leszqq/usb-magnetometer.hardware/usb-magnetometer.step

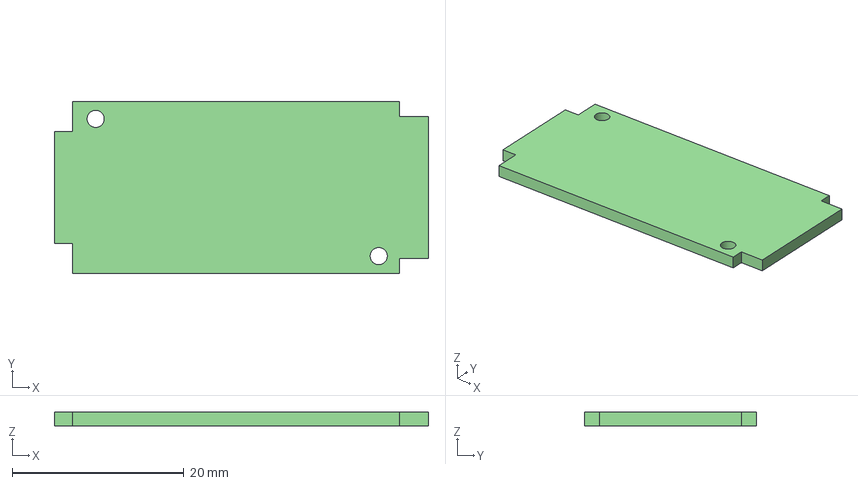
[picture p1: CAD file, 2023-02-05]
usb-magnetometer.step
43.6 x 20.0 x 1.60 mm
