leszqq/usb-magnetometer.hardware/sch.pdf

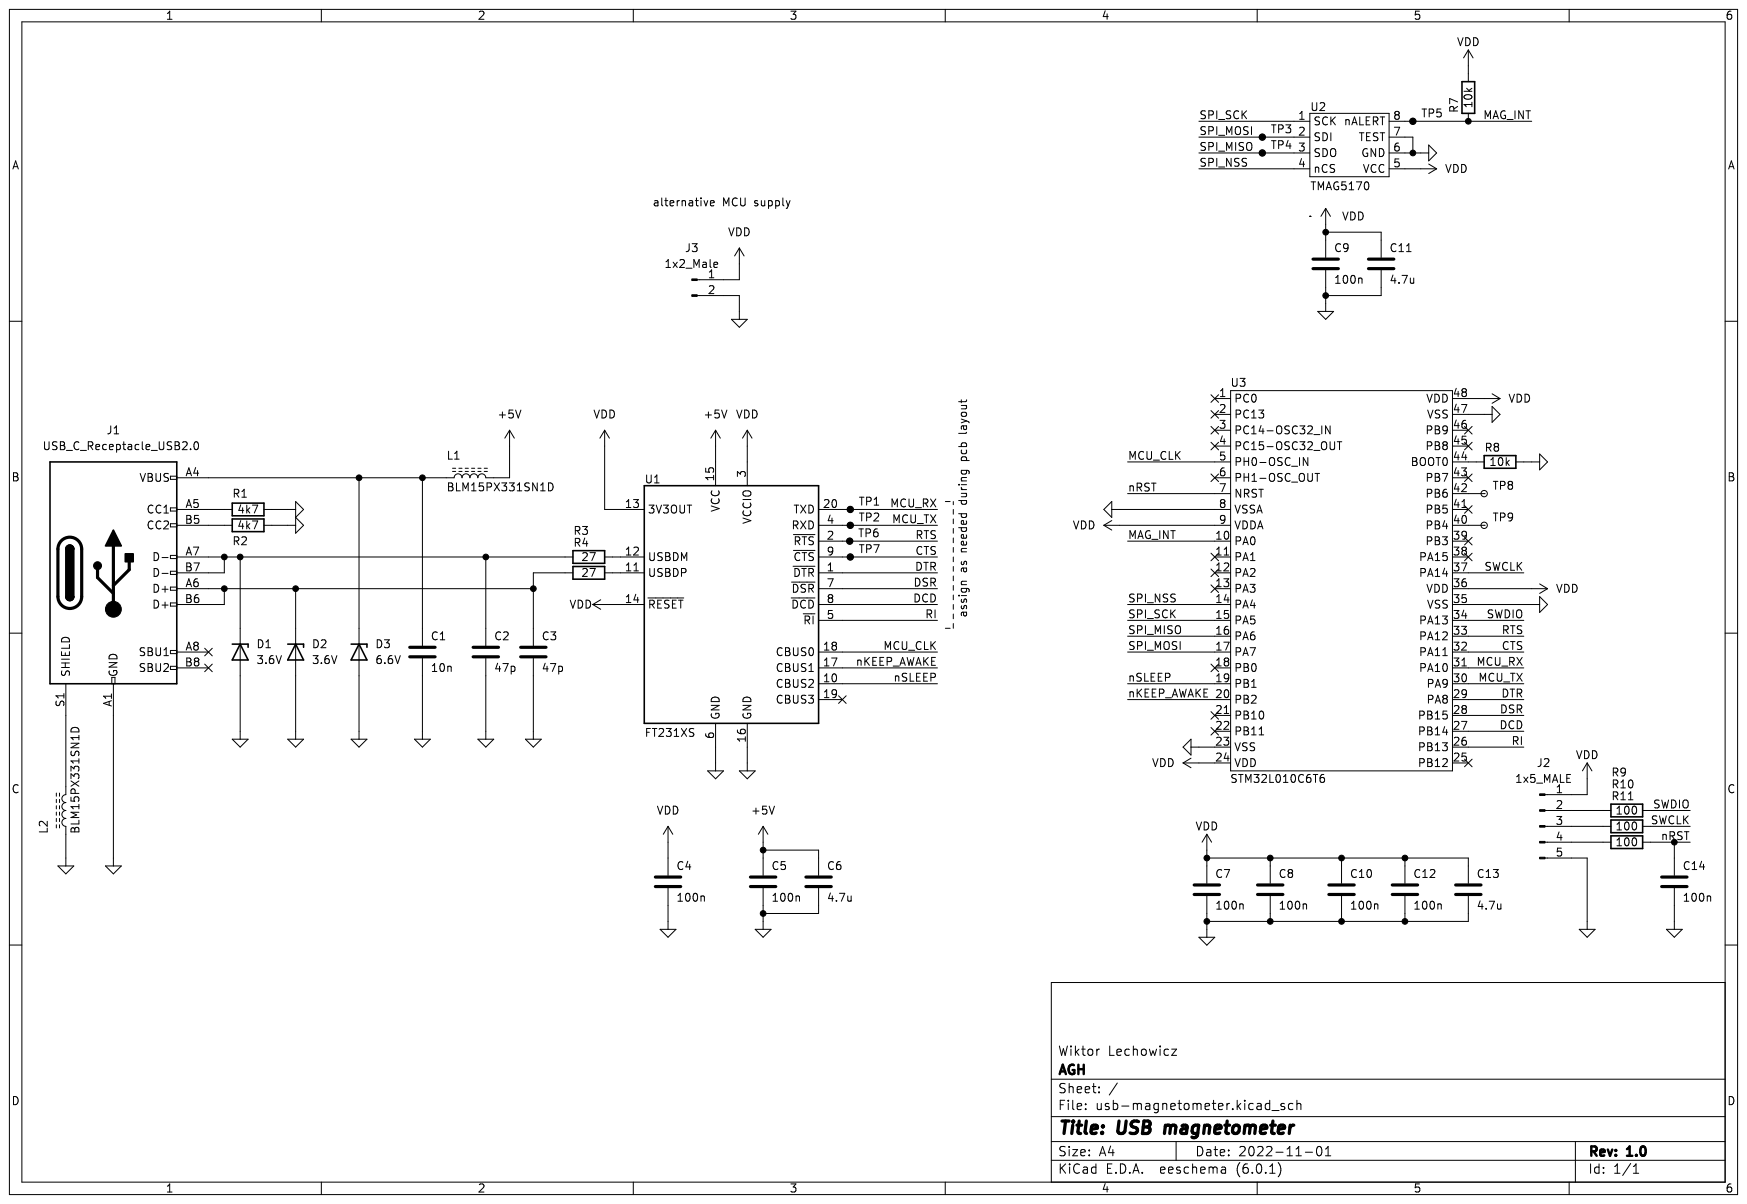
[picture p2: page 1]
