leszqq/usb-magnetometer.hardware/usb-magnetometer.kicad_pcb

## KiCad design usb-magnetometer.kicad_pcb (2023-03-18)

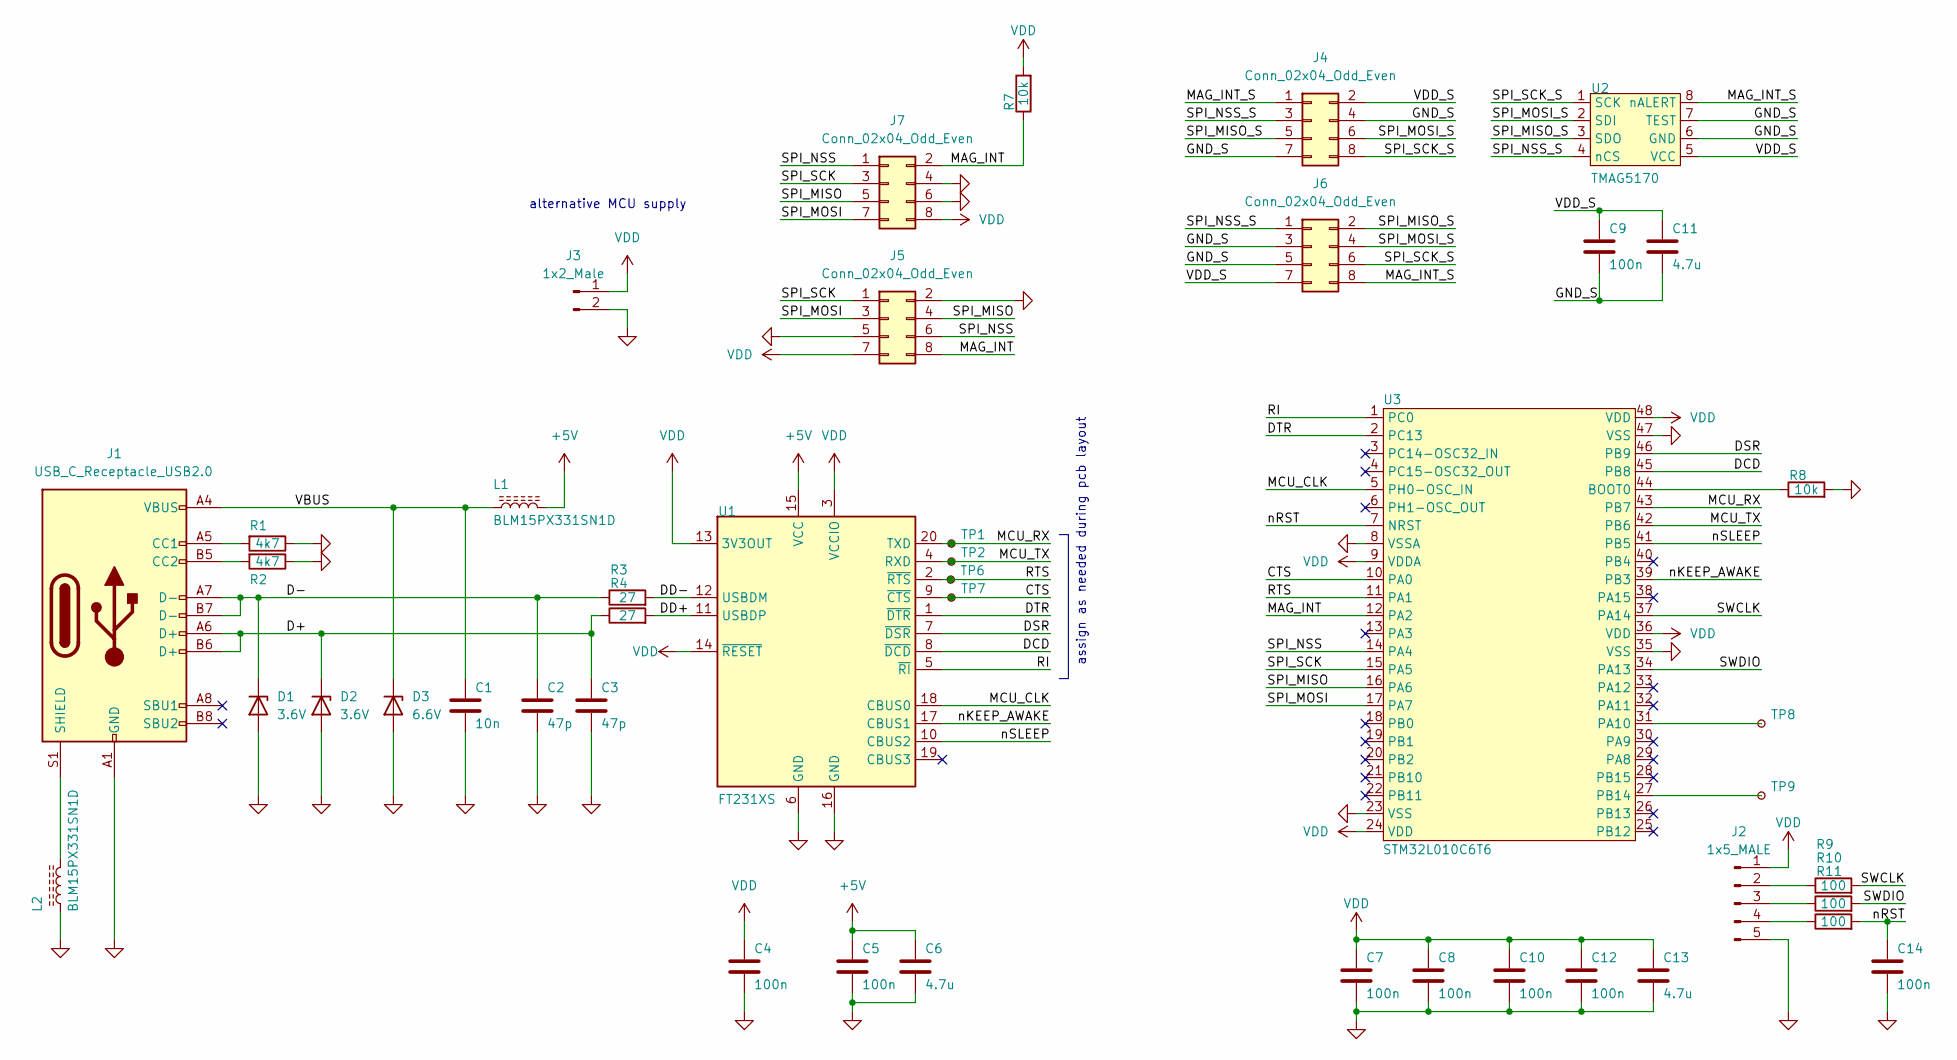
[picture p3: schematic usb-magnetometer.kicad_sch, USB magnetometer]

Parts:
C1: 10n; C_0402_1005Metric_Pad0.74x0.62mm_HandSolder; MPN VJ0402Y103JXQCW1BC
C2, C3: 47p; C_0402_1005Metric_Pad0.74x0.62mm_HandSolder; MPN CC0402JRNPO8BN470
C4, C5, C7, C8, C9, C10, C12, C14: 100n; C_0402_1005Metric_Pad0.74x0.62mm_HandSolder; MPN CL05A104KP5NNNC
C6, C11, C13: 4.7u; C_0402_1005Metric_Pad0.74x0.62mm_HandSolder; MPN CL05A475MP5NRNC
D1, D2: 3.6V; X1SON; MPN ESD321DPYR
D3: 6.6V; D_SOD-323_HandSoldering; MPN ESD3Z5V0
J1: USB_C_Receptacle_USB2.0; USB_C_Receptacle_JAE_DX07S016JA1R1500; MPN DX07S016JA1R1500
J2: 1x5_MALE; PinHeader_1x05_P2.54mm_Vertical; MPN *
J3: 1x2_Male; PinHeader_1x02_P2.54mm_Vertical; MPN *
J4, J5: Conn_02x04_Odd_Even; Hirose_FH12-8S-0.5SH_1x08-1MP_P0.50mm_Horizontal
J6, J7: Conn_02x04_Odd_Even; PinHeader_2x04_P1.00mm_Vertical
L1, L2: L_Ferrite; R_0402_1005Metric_Pad0.72x0.64mm_HandSolder; MPN BLM15PX331SN1D
R1, R2: 4k7; R_0402_1005Metric_Pad0.72x0.64mm_HandSolder; MPN RC0402JR-134K7L
R3, R4: 27; R_0402_1005Metric_Pad0.72x0.64mm_HandSolder; MPN RC0402JR-0727RL
R7, R8: 10k; R_0402_1005Metric_Pad0.72x0.64mm_HandSolder; MPN RC0402FR-0710KL
R9, R10, R11: 100; R_0402_1005Metric_Pad0.72x0.64mm_HandSolder; MPN RC0402FR-07100R
TP1, TP2, TP6, TP7, TP8, TP9: TestPoint_Small; TestPoint_Pad_D1.0mm
U1: FT231XS; SSOP-20_3.9x8.7mm_P0.635mm; MPN FT231XS-R
U2: TMAG5170; VSSOP-8_3.0x3.0mm_P0.65mm; MPN TMAG5170A1EDGKRQ1
U3: STM32L010C6T6; LQFP-48_7x7mm_P0.5mm; MPN STM32L010C6T6

Connections:
+5V: C5.1, C6.1, L1.2, U1.15 (VCC)
/CTS: TP7.1, U1.9 (~CTS), U3.10 (PA0)
/D+: C3.1, D2.1 (K), J1.A6 (D+), J1.B6 (D+), R4.1
/D-: C2.1, D1.1 (K), J1.A7 (D-), J1.B7 (D-), R3.1
/DCD: U1.8 (~DCD), U3.45 (PB8)
/DD+: R4.2, U1.11 (USBDP)
/DD-: R3.2, U1.12 (USBDM)
/DSR: U1.7 (~DSR), U3.46 (PB9)
/DTR: U1.1 (~DTR), U3.2 (PC13)
/GND_S: C9.2, C11.2, J4.4, J4.7, J6.3, J6.5, U2.6 (GND), U2.7 (TEST)
/MAG_INT: J5.8, J7.2, R7.1, U3.12 (PA2)
/MAG_INT_S: J4.1, J6.8, U2.8 (nALERT)
/MCU_CLK: U1.18 (CBUS0), U3.5 (PH0-OSC_IN)
/MCU_RX: TP1.1, U1.20 (TXD), U3.43 (PB7)
/MCU_TX: TP2.1, U1.4 (RXD), U3.42 (PB6)
/RI: U1.5 (~RI), U3.1 (PC0)
/RTS: TP6.1, U1.2 (~RTS), U3.11 (PA1)
/SPI_MISO: J5.4, J7.5, U3.16 (PA6)
/SPI_MISO_S: J4.5, J6.2, U2.3 (SDO)
/SPI_MOSI: J5.3, J7.7, U3.17 (PA7)
/SPI_MOSI_S: J4.6, J6.4, U2.2 (SDI)
/SPI_NSS: J5.6, J7.1, U3.14 (PA4)
/SPI_NSS_S: J4.3, J6.1, U2.4 (nCS)
/SPI_SCK: J5.1, J7.3, U3.15 (PA5)
/SPI_SCK_S: J4.8, J6.6, U2.1 (SCK)
/SWCLK: R9.2, U3.37 (PA14)
/SWDIO: R10.2, U3.34 (PA13)
/VBUS: C1.1, D3.1 (K), J1.A4 (VBUS), J1.A9 (VBUS), J1.B4 (VBUS), J1.B9 (VBUS), L1.1
/VDD_S: C9.1, C11.1, J4.2, J6.7, U2.5 (VCC)
/nKEEP_AWAKE: U1.17 (CBUS1), U3.39 (PB3)
/nRST: C14.1, R11.2, U3.7 (NRST)
/nSLEEP: U1.10 (CBUS2), U3.41 (PB5)
GND: C1.2, C2.2, C3.2, C4.2, C5.2, C6.2, C7.2, C8.2, C10.2, C12.2, C13.2, C14.2, D1.2 (A), D2.2 (A), D3.2 (A), J1.A1 (GND), J1.A12 (GND), J1.B1 (GND), J1.B12 (GND), J2.5, J3.2, J5.2, J5.5, J7.4, J7.6, L2.1, R1.1, R2.1, R8.2, U1.6 (GND), U1.16 (GND), U3.8 (VSSA), U3.23 (VSS), U3.35 (VSS), U3.47 (VSS)
unnamed: J1.A5 (CC1), R1.2
unnamed: J1.B5 (CC2), R2.2
unnamed: J1.S1 (SHIELD), L2.2
unnamed: J2.2, R9.1
unnamed: J2.3, R10.1
unnamed: J2.4, R11.1
unnamed: R8.1, U3.44 (BOOT0)
unnamed: TP8.1, U3.31 (PA10)
unnamed: TP9.1, U3.27 (PB14)
VDD: C4.1, C7.1, C8.1, C10.1, C12.1, C13.1, J2.1, J3.1, J5.7, J7.8, R7.2, U1.3 (VCCIO), U1.13 (3V3OUT), U1.14 (~RESET), U3.9 (VDDA), U3.24 (VDD), U3.36 (VDD), U3.48 (VDD)

Notes on the sheet:
assign as needed during pcb layout
alternative MCU supply

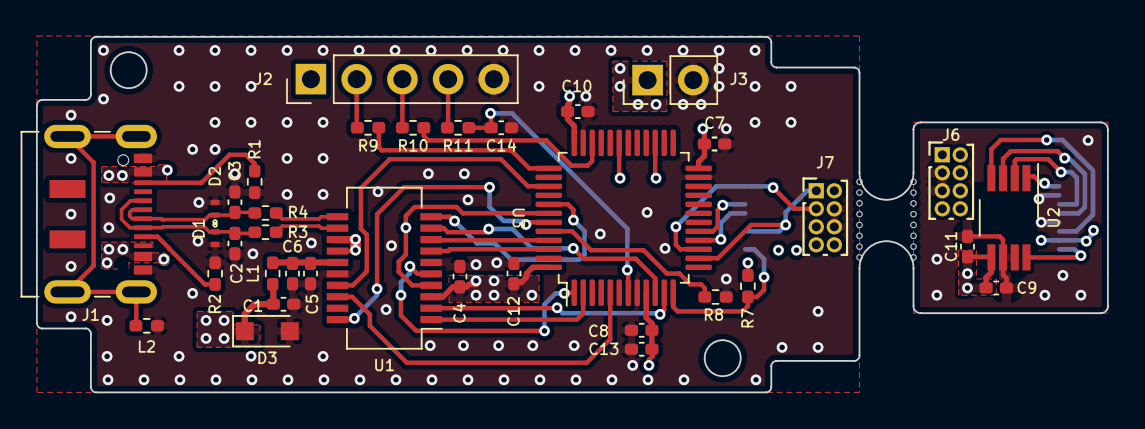
[picture p4: board usb-magnetometer.kicad_pcb from above]

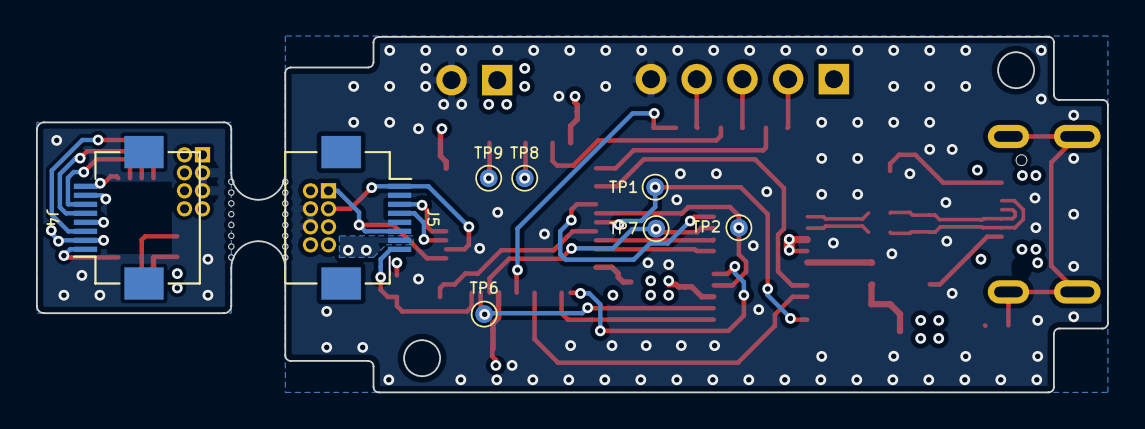
[picture p5: board usb-magnetometer.kicad_pcb from below]

Board: 4 copper layers, 59.5 x 19.8 mm, 44 parts (8 on the bottom side), 43 nets.
