leszqq/usb-magnetometer.hardware/(commit log)

2023-02-05 Add v1.0 files
    [usb-magnetometer-B_Cu.gbr, usb-magnetometer-B_Mask.gbr, usb-magnetometer-B_Paste.gbr, usb-magnetometer-B_Silkscreen.gbr, usb-magnetometer-Edge_Cuts.gbr, usb-magnetometer-F_Cu.gbr, usb-magnetometer-F_Mask.gbr, usb-magnetometer-F_Paste.gbr]
2023-03-12 Add initial version of separated pcbs
    [usb-magnetometer.kicad_pcb, usb-magnetometer.kicad_sch]
2023-03-14 Update conenctors designators size
    [usb-magnetometer.kicad_pcb]
2023-03-18 FPC connectors in progress
    [usb-magnetometer.kicad_pcb, usb-magnetometer.kicad_sch]
2023-03-18 Add final version with sensor on separated pcb
    [usb-magnetometer.kicad_pcb, usb-magnetometer.kicad_sch]
2023-03-18 Add fabrication outputs
    [usb-magnetometer-B_Cu.gbl, usb-magnetometer-B_Cu.gbr, usb-magnetometer-B_Mask.gbr, usb-magnetometer-B_Mask.gbs, usb-magnetometer-B_Paste.gbp, usb-magnetometer-B_Paste.gbr, usb-magnetometer-B_Silkscreen.gbo, usb-magnetometer-B_Silkscreen.gbr]
2023-03-18 Make two pcb as one design
    [usb-magnetometer-B_Cu.gbl, usb-magnetometer-B_Mask.gbs, usb-magnetometer-B_Paste.gbp, usb-magnetometer-B_Silkscreen.gbo, usb-magnetometer-Edge_Cuts.gm1, usb-magnetometer-F_Cu.gtl, usb-magnetometer-F_Mask.gts, usb-magnetometer-F_Paste.gtp]
